sp7q/HS-LDZ_badge/HS badge - presentation.pdf

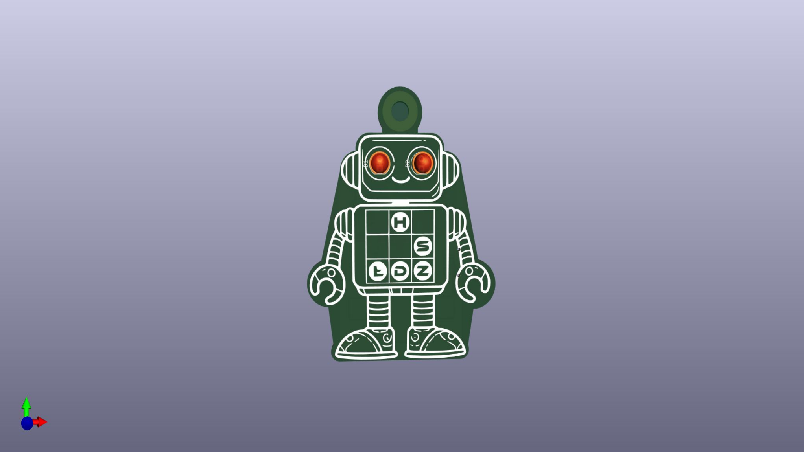
[picture p6: page 1]

# HS badge - nauka lutowania

### Założenia

### - prosty układ - niewielka ilość elementów - relatywnie krótki czas złożenia - walor użytkowy

LM3909

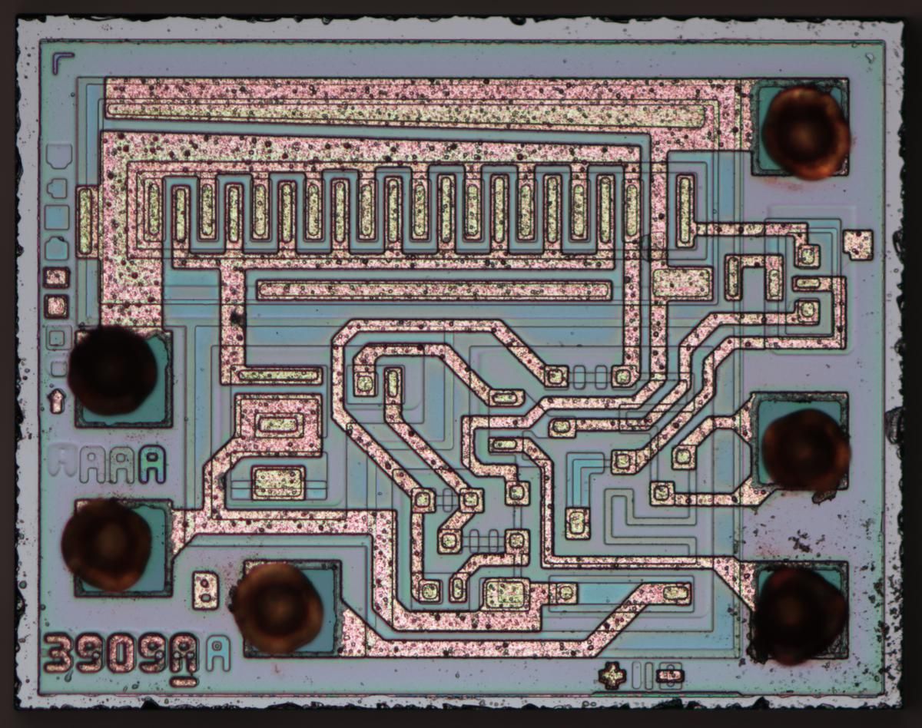
[picture p7: figure]

LM3909

### - zaprojektowany w 1975 r - minimalna ilość elementów zewnętrznych - umożliwiał sterowanie 2V diody z baterii 1.5V - https://www.righto.com/2021/01/reverse-engineering-low-power-led.html - https://softsolder.com/2020/09/03/discrete-transistor-lm3909-led-flasher/

LM3909

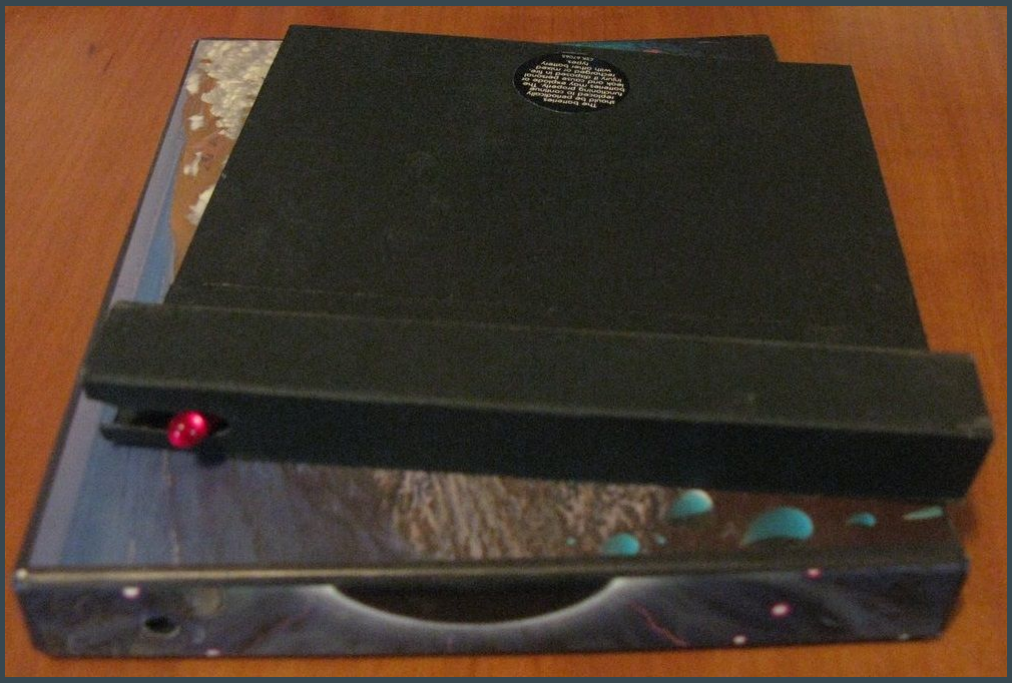
[picture p8: figure]

LM3909

Early CD versions came with a flashing red LED on the side of the case. This was designed by the EMI contractor Jon Kempner, who was awarded the platinum disc, using the now discontinued LM3909 LED flasher IC. The circuit was powered by a single AA battery; the battery life was stated to be over six months. Some versions were also made with two AA batteries and later editions of the CD set did not feature the blinking LED.[citation needed]

Essentially, it's a device which we thought was entertaining. It's an idea of Storm Thorgerson's which related to Dark Side and the pulse, and it's a live album so the box is "alive". After that, in terms of seriously deep meanings, one might be struggling a bit.

—Nick Mason[4]

# Jak to działa

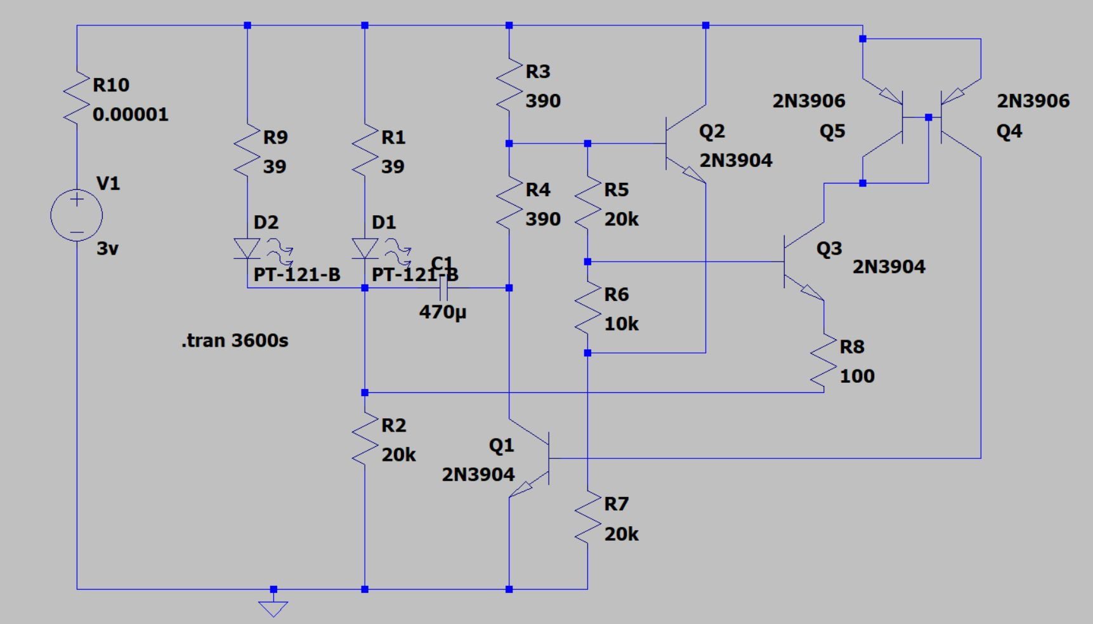
[picture p9: figure]

# Jak to działa

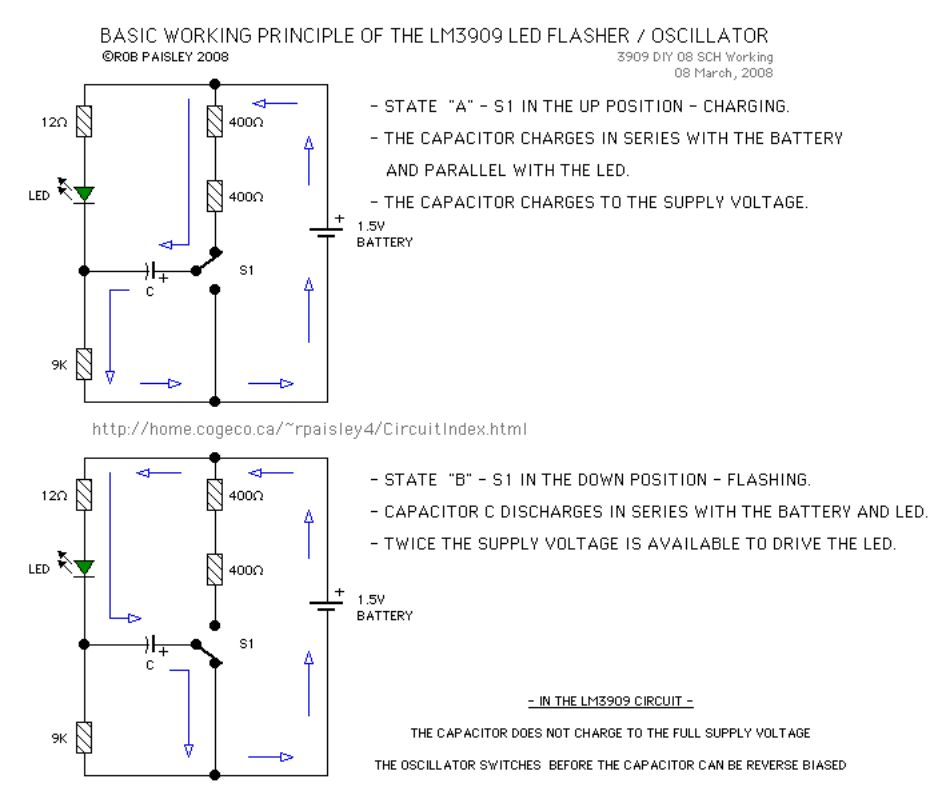
[picture p10: figure]

# Lutujemy !

### BEZPIECZEŃSTWO TO PODSTAWA

### - lutownica jest gorąca ! - nie łapiemy za czynny element lutownicy - kontrolujemy co robimy i swoje otoczenie

# Lutujemy !

### Kolejność montażu

### - od najmniejszych do największych elementów - Tranzystory Q - Rezystory R - Wyłącznik - Kondensator - Koszyczek na baterię - Diody

# Lutujemy !

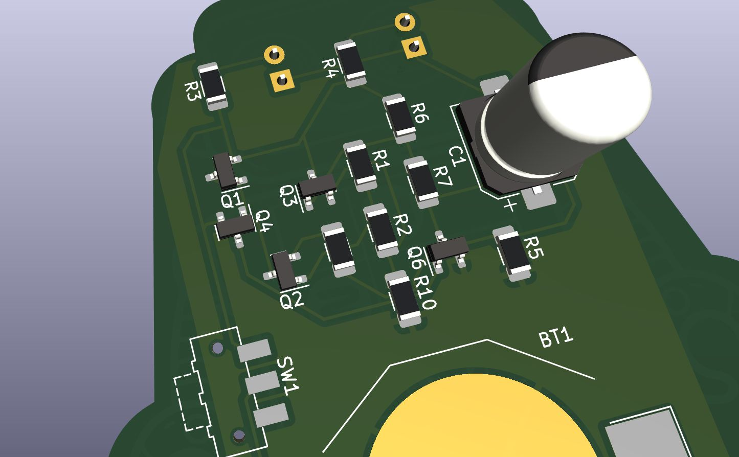
[picture p11: figure]

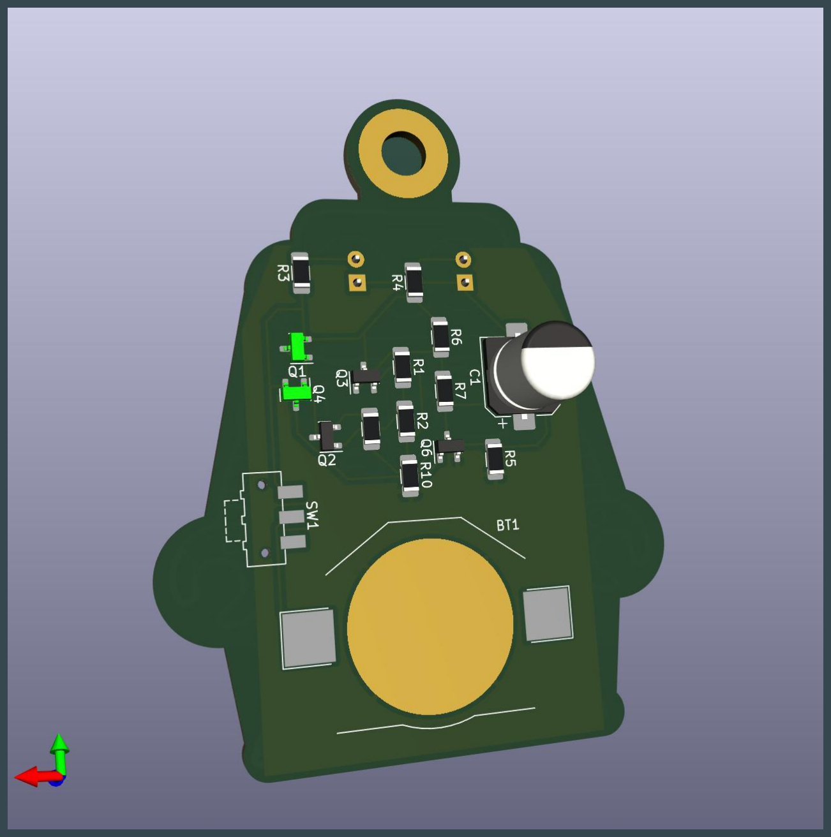
[picture p12: figure]

3906

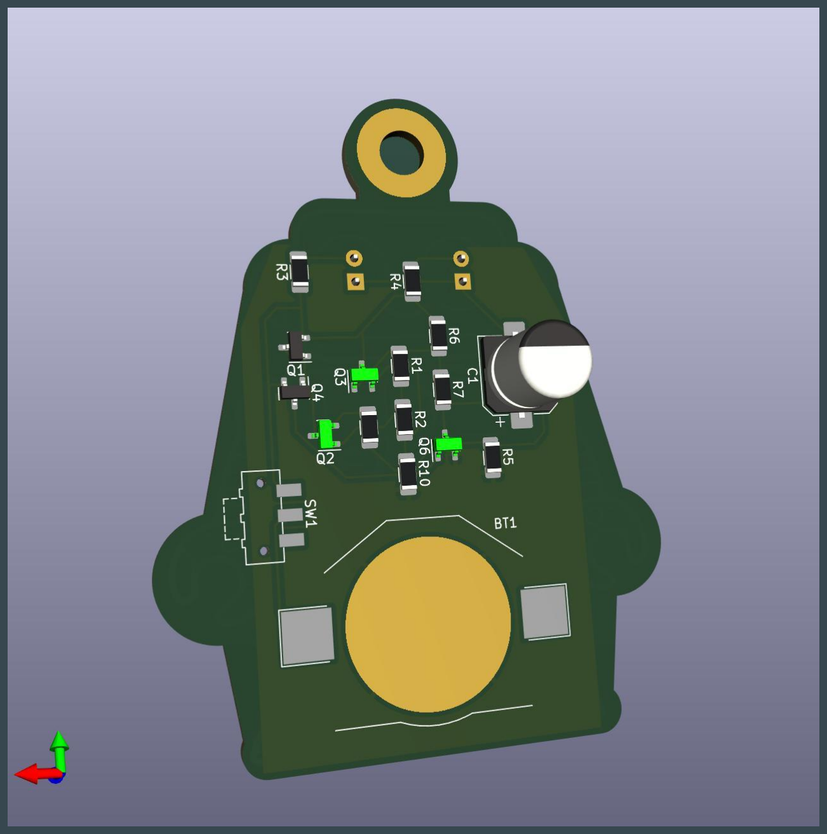
[picture p13: figure]

3904

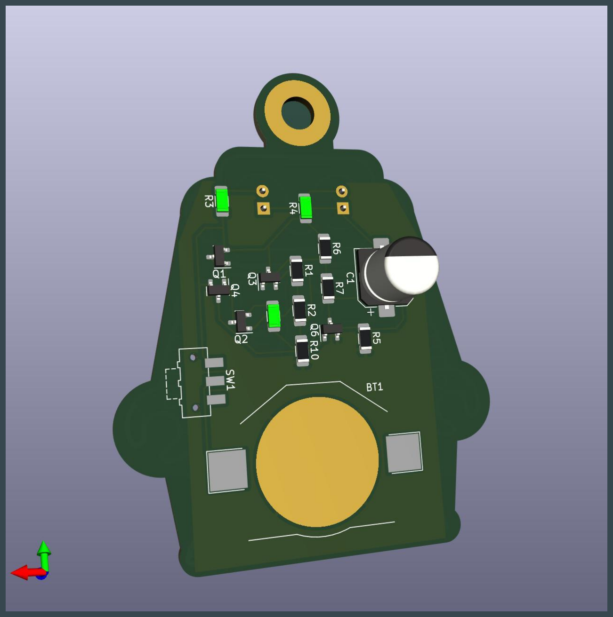
[picture p14: figure]

# 100ohm

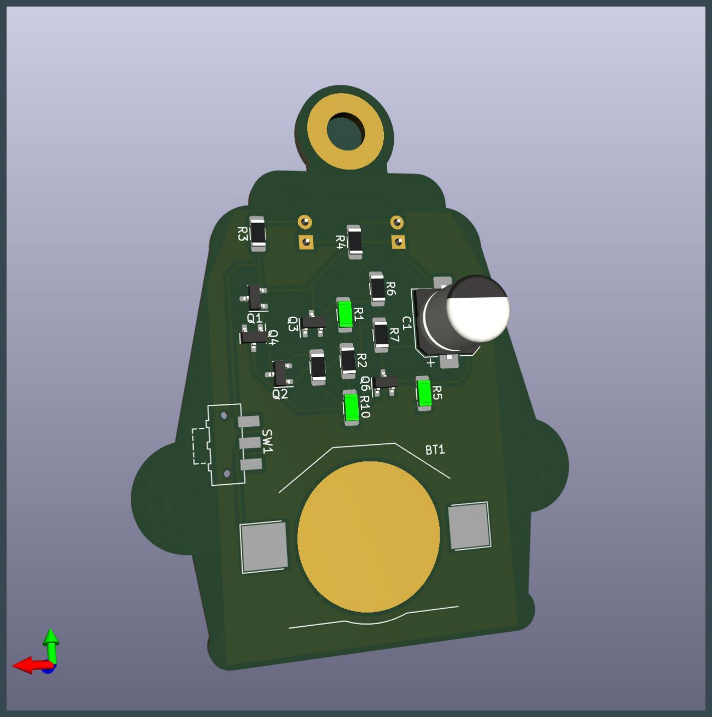
[picture p15: figure]

20k

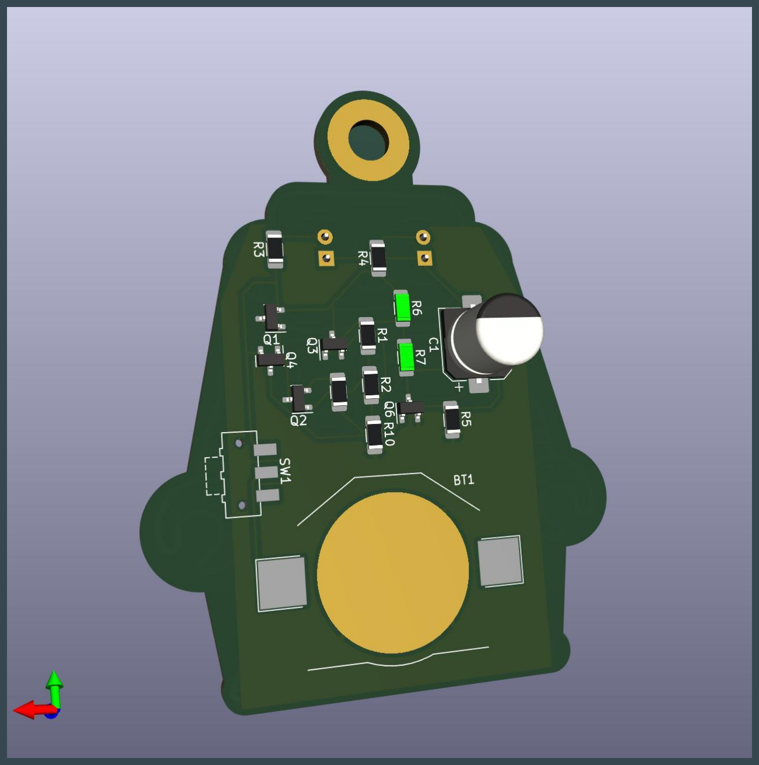
[picture p16: figure]

# 390ohm

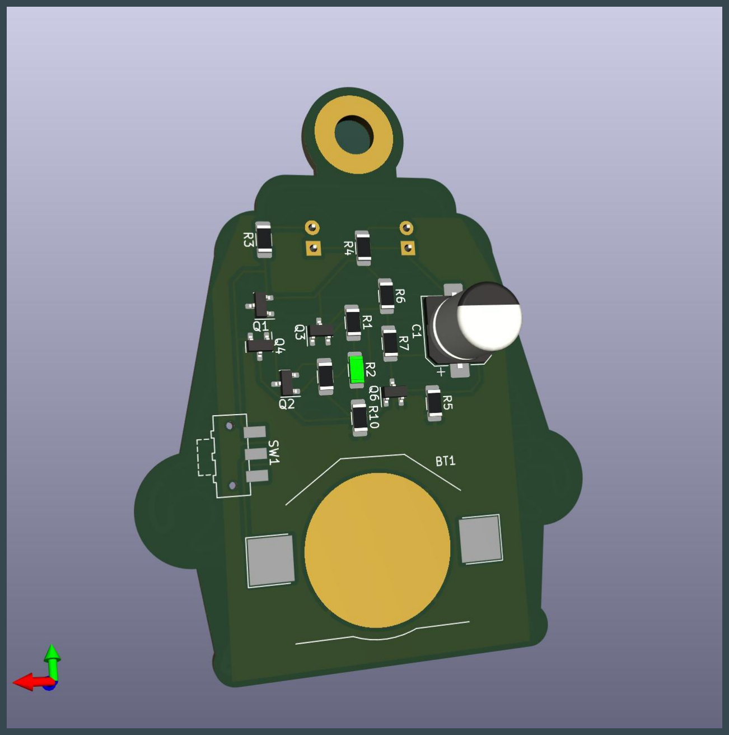
[picture p17: figure]

10k

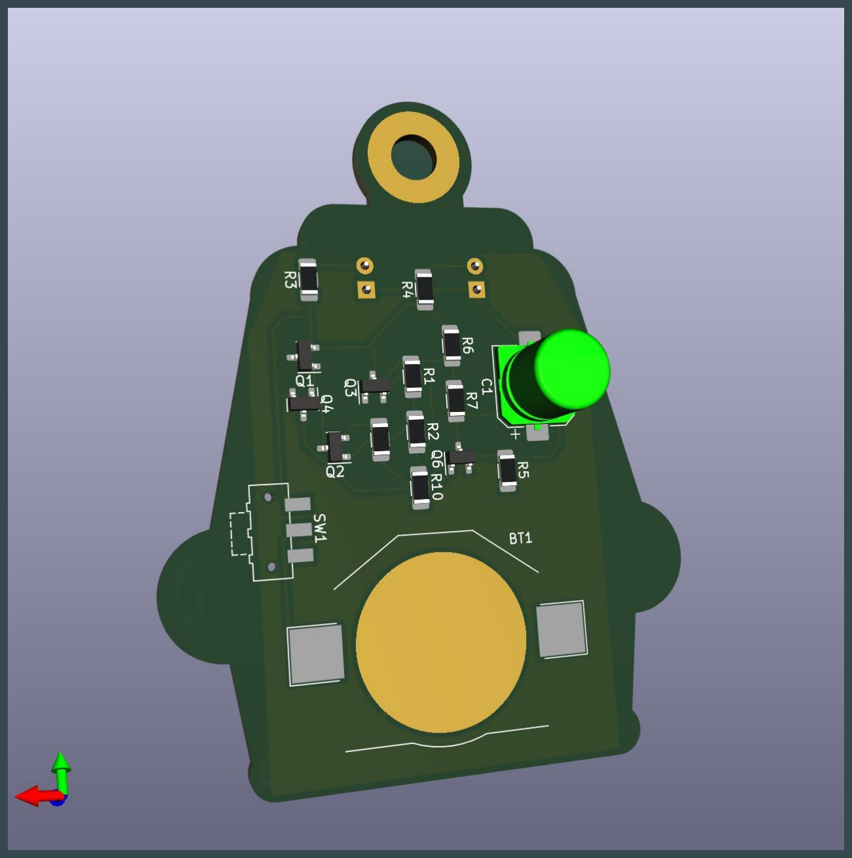
[picture p18: figure]

# Kondnsator

# Włącznik + koszyk na baterię

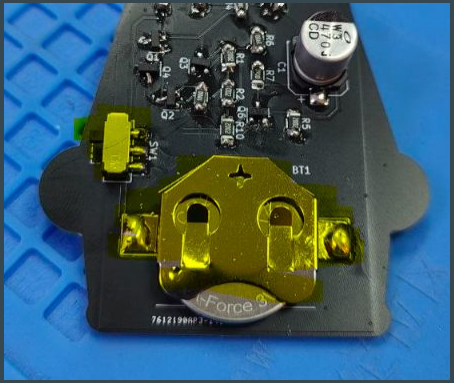
[picture p19: figure]

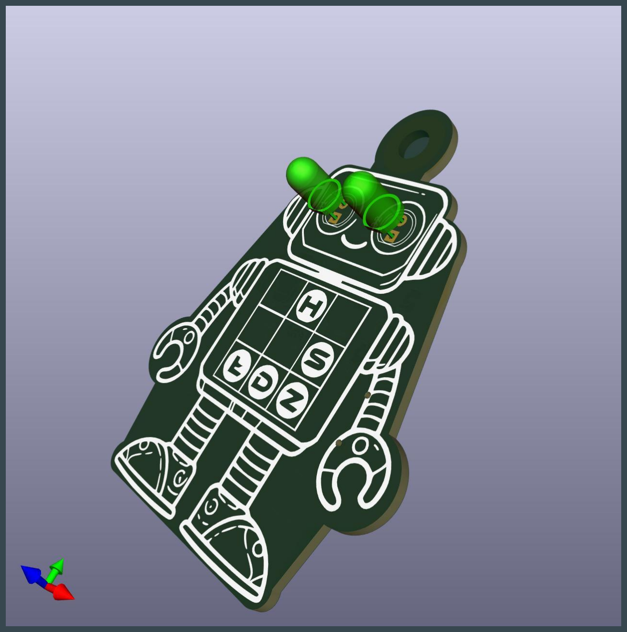
[picture p20: figure]

# LED

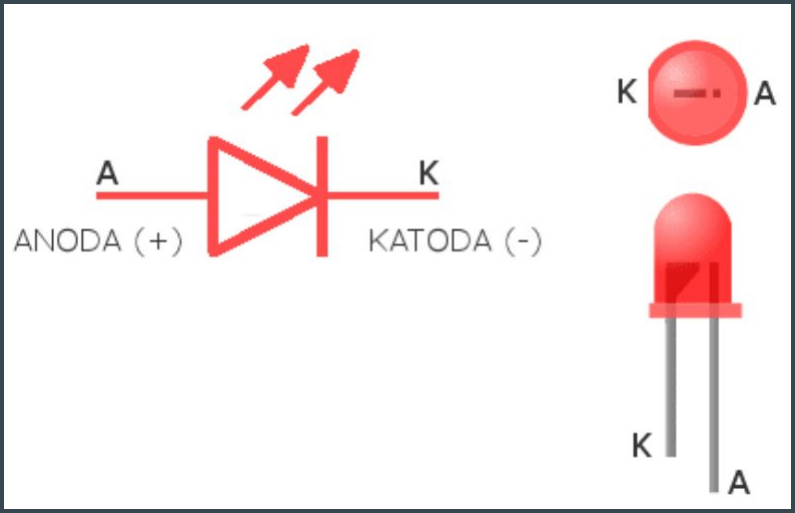
[picture p21: figure]

# LED

# Uruchamiamy !!
