sp7q/HS-LDZ_badge/BOM.md

### Component List

| LP | Symbol | Link | Quantity |
|----|---|---|---|
| 1  | MMBT3906 | [MMBT3906](https://www.tme.eu/pl/details/mmbt3906-dio/tranzystory-pnp-smd/diotec-semiconductor/mmbt3906/) | 2 |
| 2  | MMBT3904 | [MMBT3904](https://www.tme.eu/pl/details/mmbt3904-dio/tranzystory-npn-smd/diotec-semiconductor/mmbt3904/) | 3 |
| 3  | LED | [LED](https://www.tme.eu/pl/details/383-2sdrc_s530-a3/diody-led-tht-okragle/everlight/) | 2 |
| 4  | Capacitor| [Capacitor](https://www.tme.eu/pl/details/ucd0j471mnl1gs/kondensatory-elektrolityczne-smd/nichicon/) | 1 |
| 5  | 390 | [390](https://www.tme.eu/pl/details/smd1206-390r-1%25/rezystory-smd/royal-ohm/1206s4f3900t5e/) | 2 |
| 6  | 100 | [100](https://www.tme.eu/pl/details/mr12x1000ftl/rezystory-smd/walsin/) | 3 |
| 7  | 10k | [10k](https://www.tme.eu/pl/details/ac1206fr-0710kl/rezystory-smd/yageo/) | 1 |
| 8  | 20k | [20k](https://www.tme.eu/pl/details/crcw120620k0fktabc/rezystory-smd/vishay/) | 3 |
| 9  | CR2032 | | 1 |
| 10 | Battery holder KEY3002 | [Koszyk KEY3002](https://www.tme.eu/pl/details/keys3002/baterie-pojemniki-i-uchwyty/keystone/3002/) | 1 |
| 11 | Switch | [Switch](https://www.tme.eu/pl/details/js102011saqn/przelaczniki-suwakowe/c-k/) | 1 |
| 12 | PCB | | 1 |
