sp7q/HS-LDZ_badge/LTspice files/lm3909_discreet.asc

C1: cap; 470µ
D1: LED; PT-121-B
D2: LED; PT-121-B
Q1: npn; 2N3904
Q2: npn; 2N3904
Q3: npn; 2N3904
Q4: pnp; 2N3906
Q5: pnp; 2N3906
R1: res; 100
R2: res; 20k
R3: res; 390
R4: res; 390
R5: res; 20k
R6: res; 10k
R7: res; 20k
R8: res; 100
R9: res; 100
R10: res; 0.00001
V1: voltage; 3v
Named nets: 0
.tran 3600s
