sp7q/HS-LDZ_badge/KiCAD files/HS badge.kicad_pcb

## KiCad design KiCAD files/HS badge.kicad_pcb (2024-09-09)

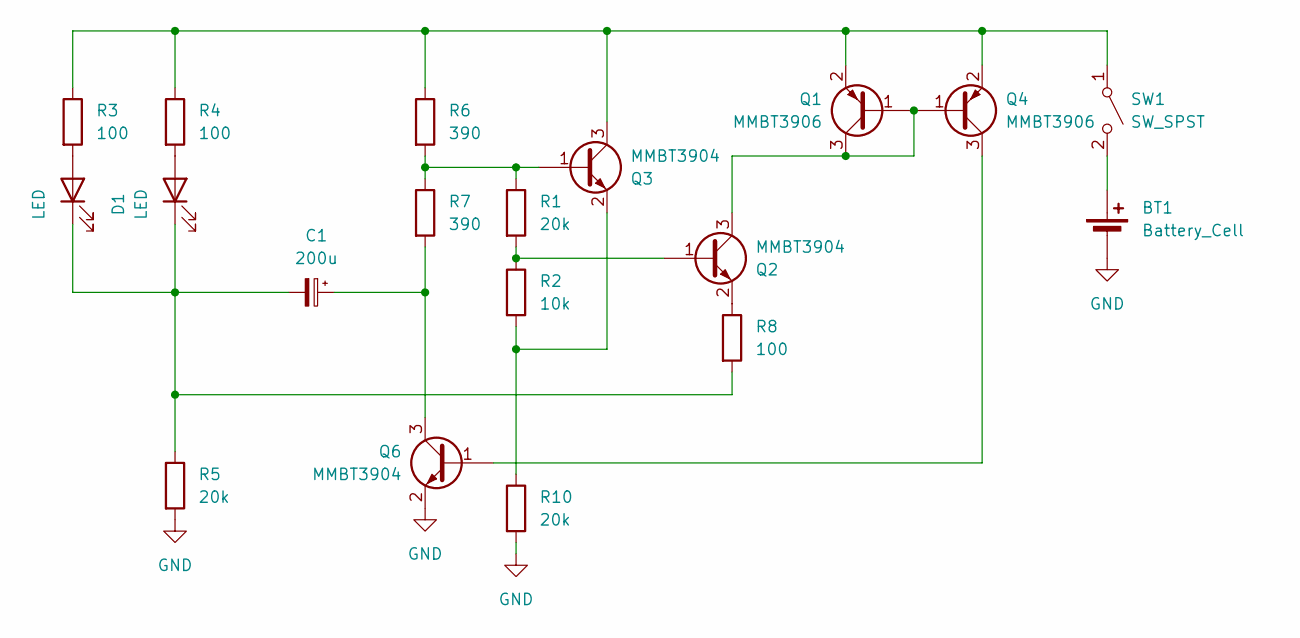
[picture p22: schematic HS badge.kicad_sch]

Parts:
BT1: Battery_Cell; BatteryHolder_Keystone_3002_1x2032
C1: 200u; CP_Elec_8x10.5
D1, D2: LED; LED_D5.0mm
Q1, Q4: MMBT3906; TSOT-23_HandSoldering
Q2, Q3, Q6: MMBT3904; TSOT-23_HandSoldering
R1, R5, R10: 20k; R_1206_3216Metric_Pad1.30x1.75mm_HandSolder
R2: 10k; R_1206_3216Metric_Pad1.30x1.75mm_HandSolder
R3, R4, R8: 100; R_1206_3216Metric_Pad1.30x1.75mm_HandSolder
R6, R7: 390; R_1206_3216Metric_Pad1.30x1.75mm_HandSolder
SW1: SW_SPST; SW_SPDT_CK-JS102011SAQN

Connections:
GND: BT1.2 (-), Q6.2 (E), R5.2, R10.2
unnamed: BT1.1 (+), SW1.2 (B)
unnamed: D1.2 (A), R4.2
unnamed: C1.2, D1.1 (K), D2.1 (K), R5.1, R8.2
unnamed: D2.2 (A), R3.2
unnamed: Q1.1 (B), Q1.3 (C), Q2.3 (C), Q4.1 (B)
unnamed: Q1.2 (E), Q3.3 (C), Q4.2 (E), R3.1, R4.1, R6.1, SW1.1 (A)
unnamed: Q2.1 (B), R1.2, R2.1
unnamed: Q2.2 (E), R8.1
unnamed: Q3.1 (B), R1.1, R6.2, R7.1
unnamed: Q3.2 (E), R2.2, R10.1
unnamed: Q4.3 (C), Q6.1 (B)
unnamed: C1.1, Q6.3 (C), R7.2

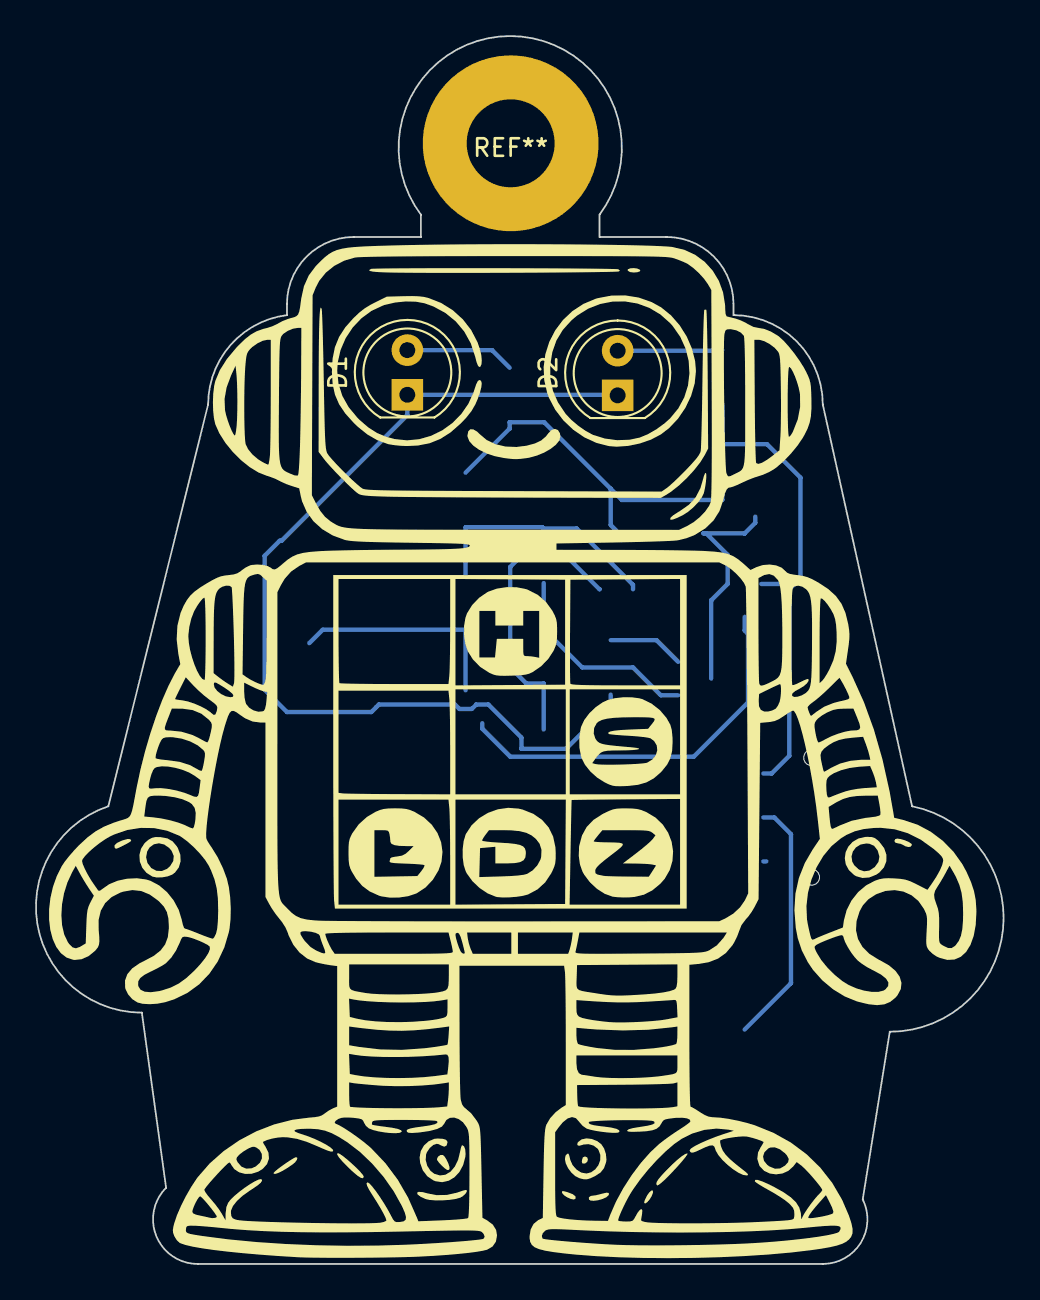
[picture p23: board HS badge.kicad_pcb from above]

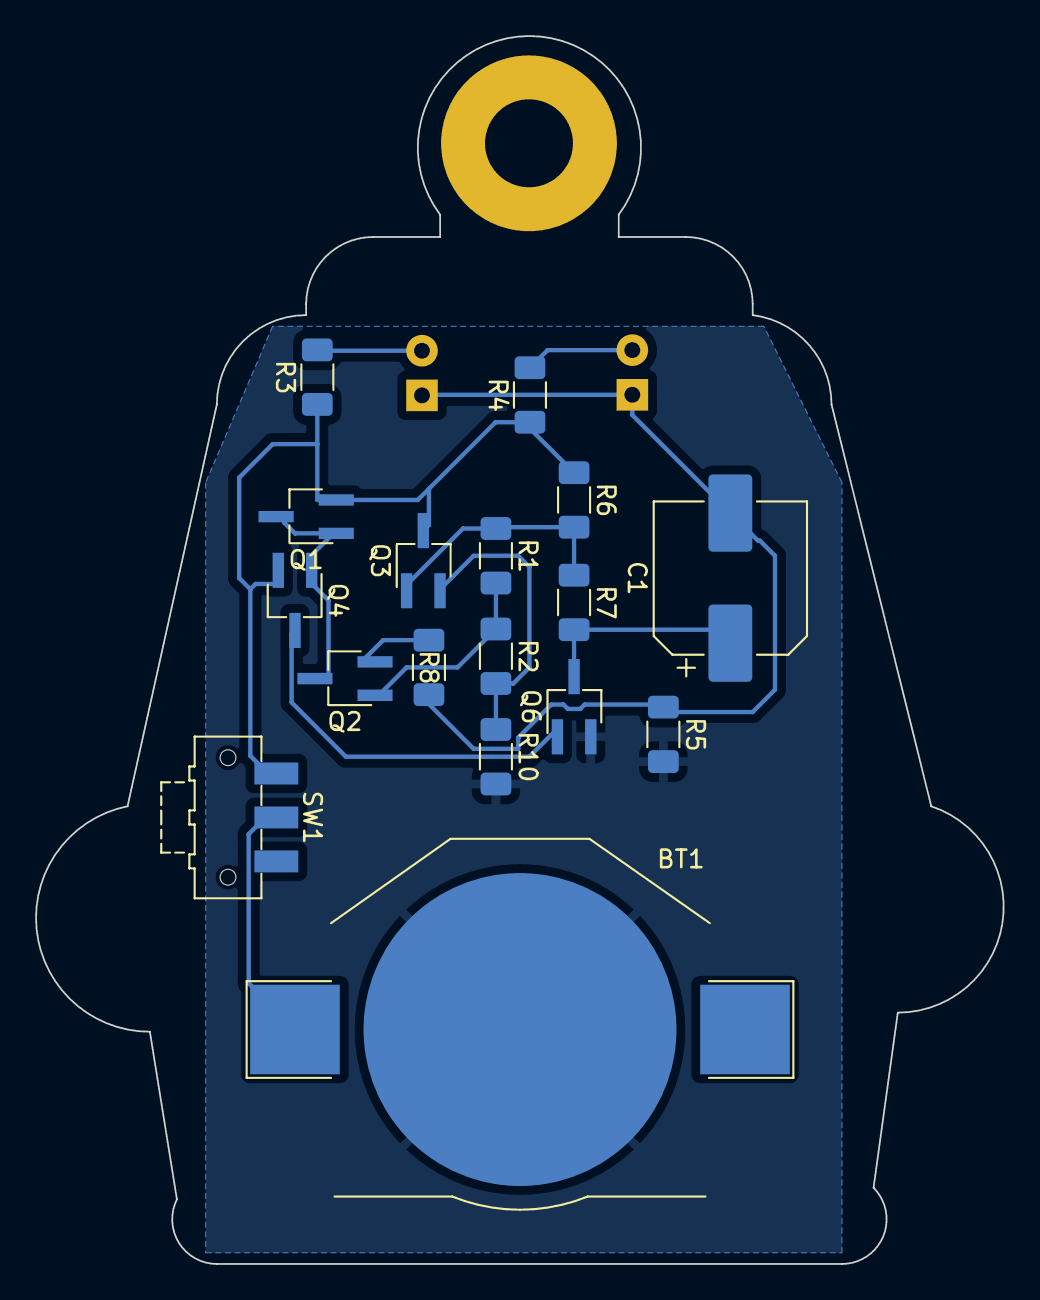
[picture p24: board HS badge.kicad_pcb from below]

Board: 2 copper layers, 55.0 x 69.8 mm, 19 parts (17 on the bottom side), 13 nets.
